aresta/ESP32-C3_Supercaps/img/boost_conv.jpg

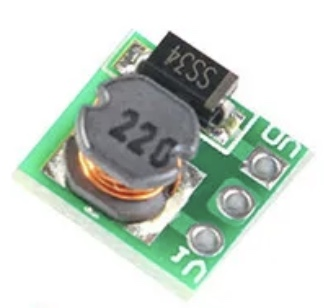
img/boost_conv.jpg
