aresta/ESP32-C3_Supercaps/img/ESP32-C3_Supermini3.jpg

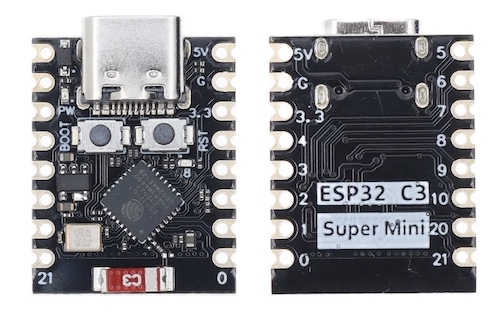
img/ESP32-C3_Supermini3.jpg
