aresta/ESP32-C3_Supercaps/img/ESP32-C3_Supermini.jpg

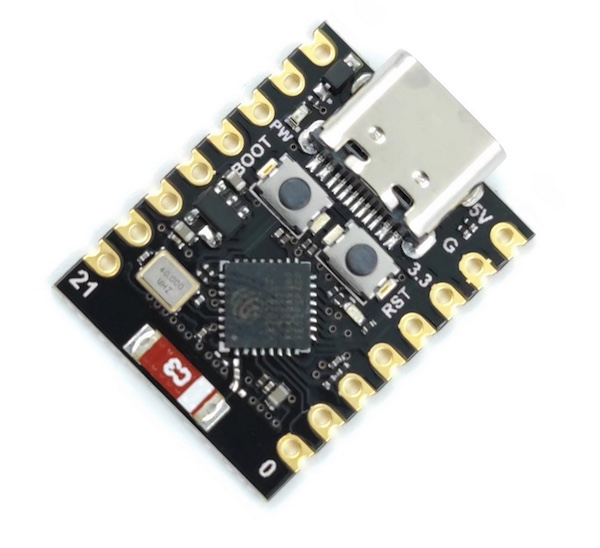
img/ESP32-C3_Supermini.jpg
