aresta/ESP32-C3_Supercaps/img/ESP32-C3_Supermini_pinout.jpeg

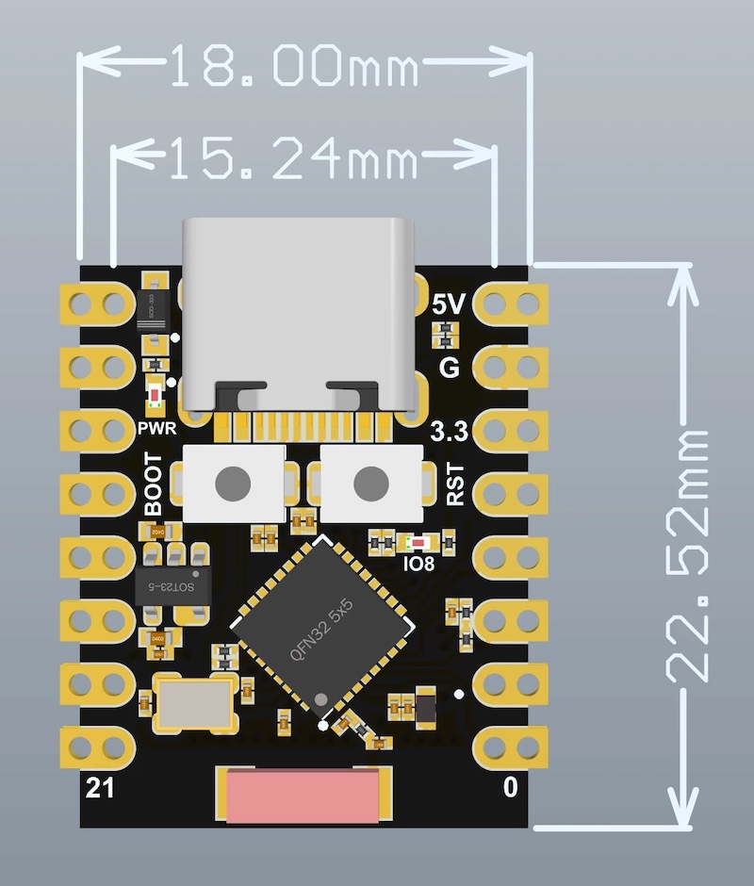
img/ESP32-C3_Supermini_pinout.jpeg
