aresta/ESP32-C3_Supercaps/img/ESP8685_sch.jpg

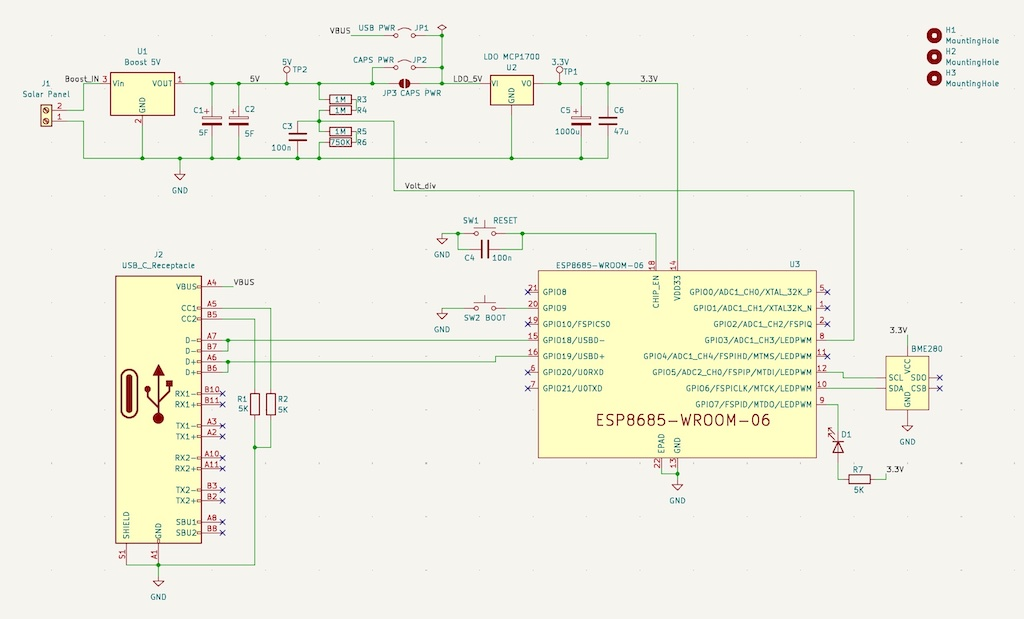
img/ESP8685_sch.jpg
