aresta/ESP32-C3_Supercaps/img/pcb.jpg

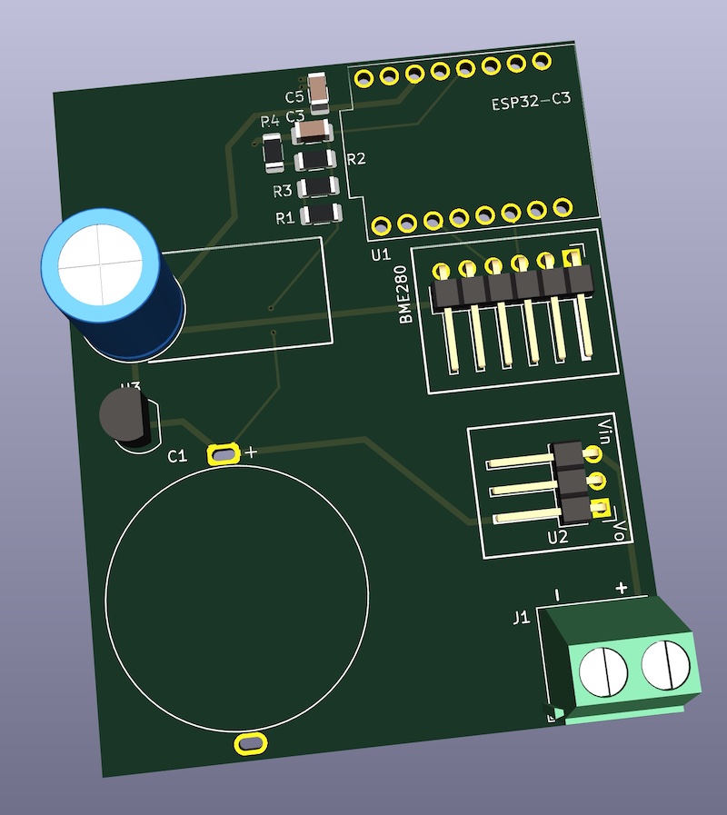
img/pcb.jpg
