aresta/ESP32-C3_Supercaps/img/solar_panel.jpg

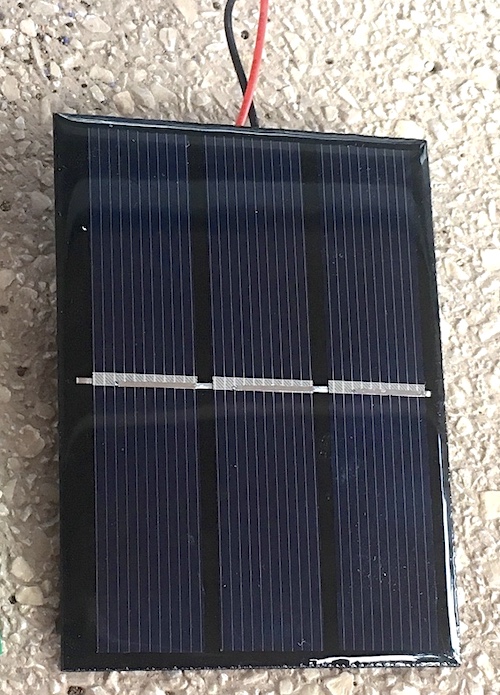
img/solar_panel.jpg
