aresta/ESP32-C3_Supercaps/img/Supercaps_5F.jpg

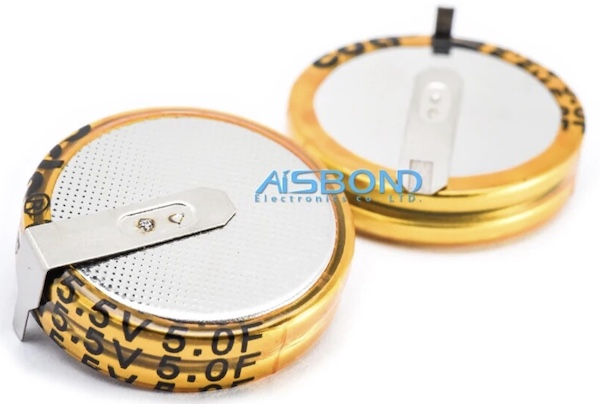
img/Supercaps_5F.jpg
