aresta/ESP32-C3_Supercaps/img/ESP8685-WeatherSt.kicad_pcb

## KiCad design img/ESP8685-WeatherSt.kicad_pcb (2026-07-29)

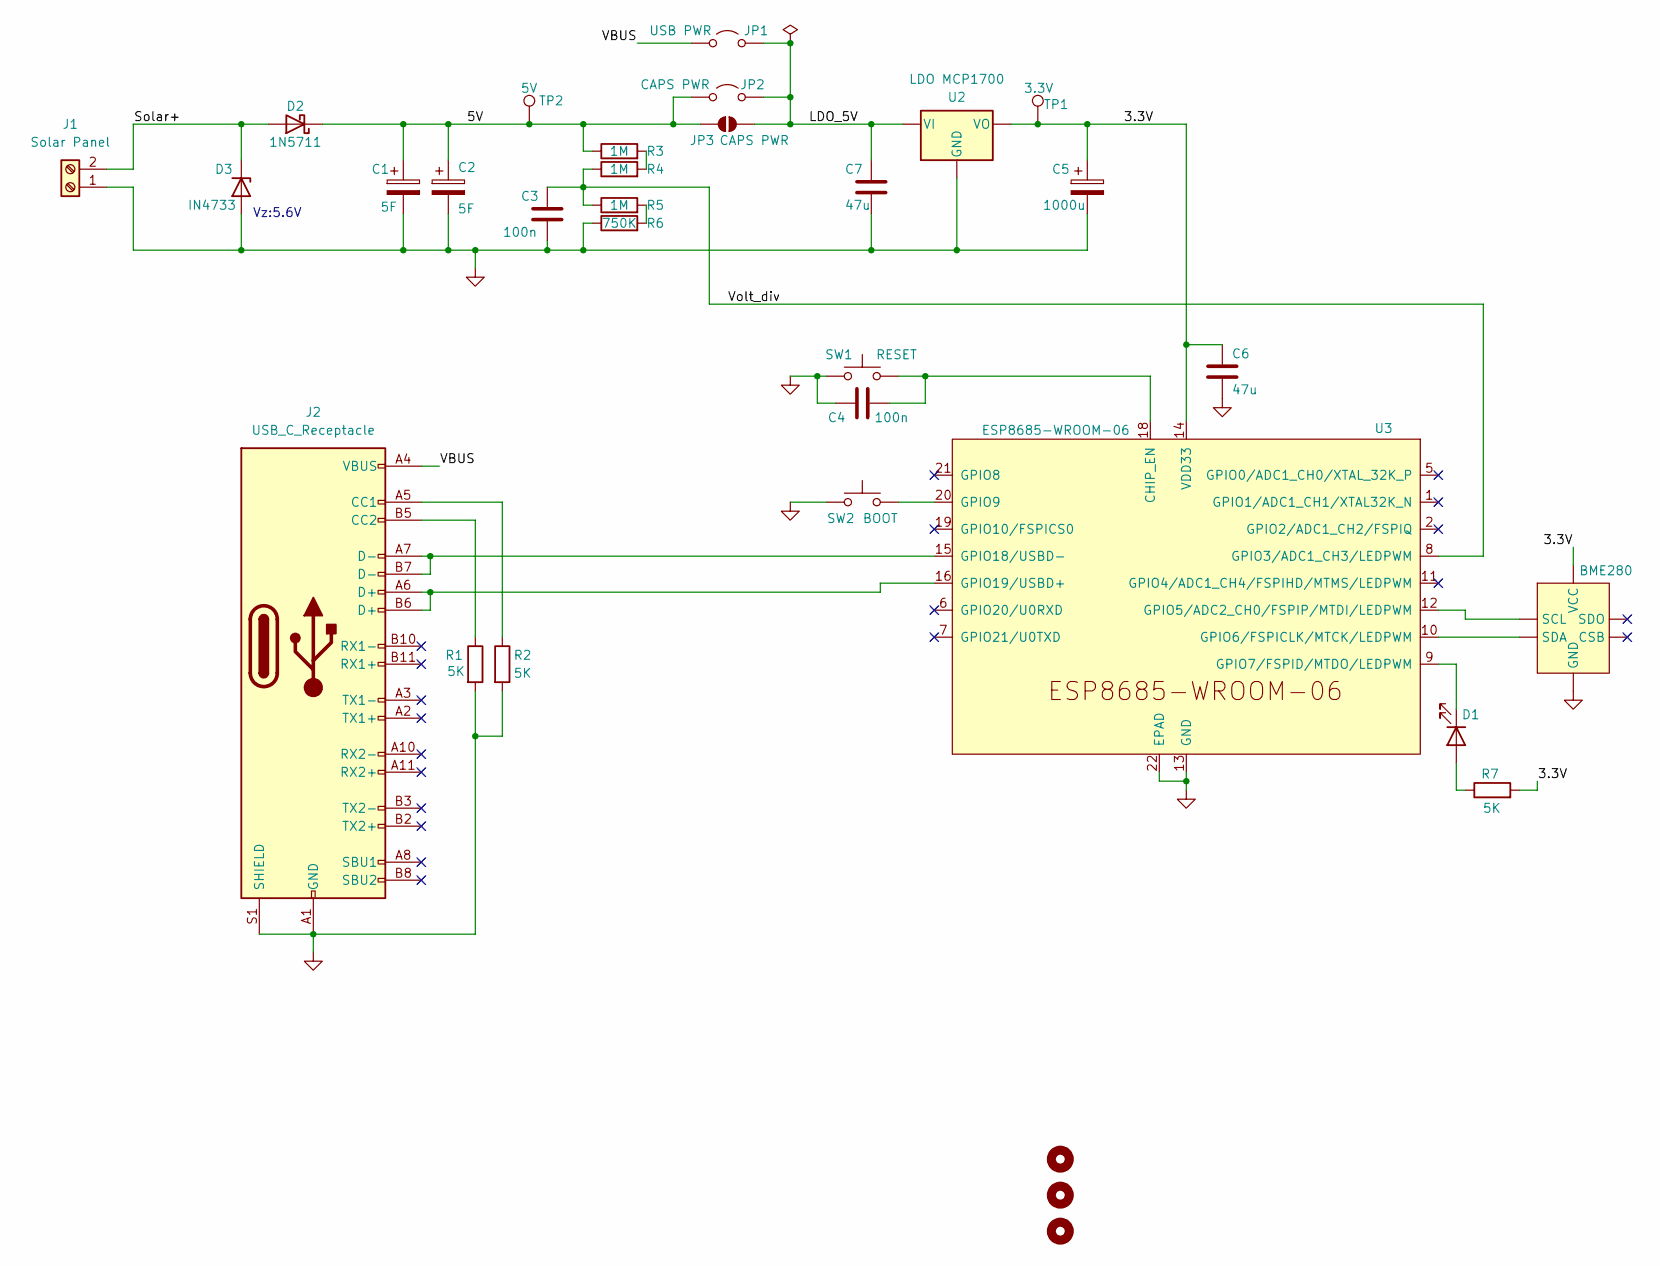
[picture p15: schematic ESP8685-WeatherSt.kicad_sch]

Parts:
BME1: BME280; PinHeader_1x06_P2.54mm_Horizontal
C1, C2: 5F; supercap
C3, C4: 100n; C_1206_3216Metric
C5: 1000u; C_Radial_D10.0mm_H16.0mm_P5.00mm
C6, C7: 47u; C_1206_3216Metric
D1: LED; LED_0805_2012Metric
D2: 1N5711; D_DO-35_SOD27_P7.62mm_Horizontal
D3: IN4733; D_DO-34_SOD68_P10.16mm_Horizontal
H1, H2, H3: MountingHole; MountingHole_2.2mm_M2_DIN965
J1: Solar Panel; TerminalBlock_Phoenix_MKDS-1,5-2-5.08_1x02_P5.08mm_Horizont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
J2: USB_C_Receptacle; USB_C_Receptacle_GCT_USB4105-xx-A_16P_TopMnt_Horizontal
JP1: USB PWR; PinHeader_1x02_P2.54mm_Vertical
JP2: CAPS PWR; PinHeader_1x02_P2.54mm_Vertical
JP3: CAPS PWR; SolderJumper-2_P1.3mm_Open_RoundedPad1.0x1.5mm
R1, R2, R7: 5K; R_1206_3216Metric
R3, R4, R5: 1M; R_1206_3216Metric
R6: 750K; R_1206_3216Metric
SW1: RESET; SW_Push_1P1T_NO_6x6mm_H9.5mm
SW2: BOOT; SW_Push_1P1T_NO_6x6mm_H9.5mm
TP1: 3.3V; TestPoint_Pad_D1.5mm
TP2: 5V; TestPoint_Pad_D1.5mm
U2: LDO MCP1700; TO-92_Inline
U3: ESP8685-WROOM-06

Connections:
/3.3V: BME1.1 (VCC), C5.1, C6.1, R7.2, TP1.1, U2.3 (VO), U3.14 (VDD33)
/5V: C1.1, C2.1, D2.1 (K), JP2.1 (A), JP3.1 (A), R3.1, TP2.1
/LDO_5V: C7.1, JP1.2 (B), JP2.2 (B), JP3.2 (B), U2.2 (VI)
/Solar+: D2.2 (A), D3.1 (K), J1.2
/VBUS: J2.A4 (VBUS), J2.A9 (VBUS), J2.B4 (VBUS), J2.B9 (VBUS), JP1.1 (A)
/Volt_div: C3.1, R4.1, R5.1, U3.8 (GPIO3/ADC1_CH3/LEDPWM)
GND: BME1.2 (GND), C1.2, C2.2, C3.2, C4.1, C5.2, C6.2, C7.2, D3.2 (A), J1.1, J2.A1 (GND), J2.A12 (GND), J2.B1 (GND), J2.B12 (GND), J2.S1 (SHIELD), R1.2, R2.2, R6.1, SW1.1, SW2.1, U2.1 (GND), U3.13 (GND), U3.22 (EPAD)
unnamed: BME1.3 (SCL), U3.12 (GPIO5/ADC2_CH0/FSPIP/MTDI/LEDPWM)
unnamed: BME1.4 (SDA), U3.10 (GPIO6/FSPICLK/MTCK/LEDPWM)
unnamed: D1.2 (A), R7.1
unnamed: D1.1 (K), U3.9 (GPIO7/FSPID/MTDO/LEDPWM)
unnamed: J2.A5 (CC1), R2.1
unnamed: J2.B5 (CC2), R1.1
unnamed: R3.2, R4.2
unnamed: R5.2, R6.2
unnamed: C4.2, SW1.2, U3.18 (CHIP_EN)
unnamed: SW2.2, U3.20 (GPIO9)
unnamed: J2.A7 (D-), J2.B7 (D-), U3.15 (GPIO18/USBD-)
unnamed: J2.A6 (D+), J2.B6 (D+), U3.16 (GPIO19/USBD+)

Notes on the sheet:
Vz:5.6V

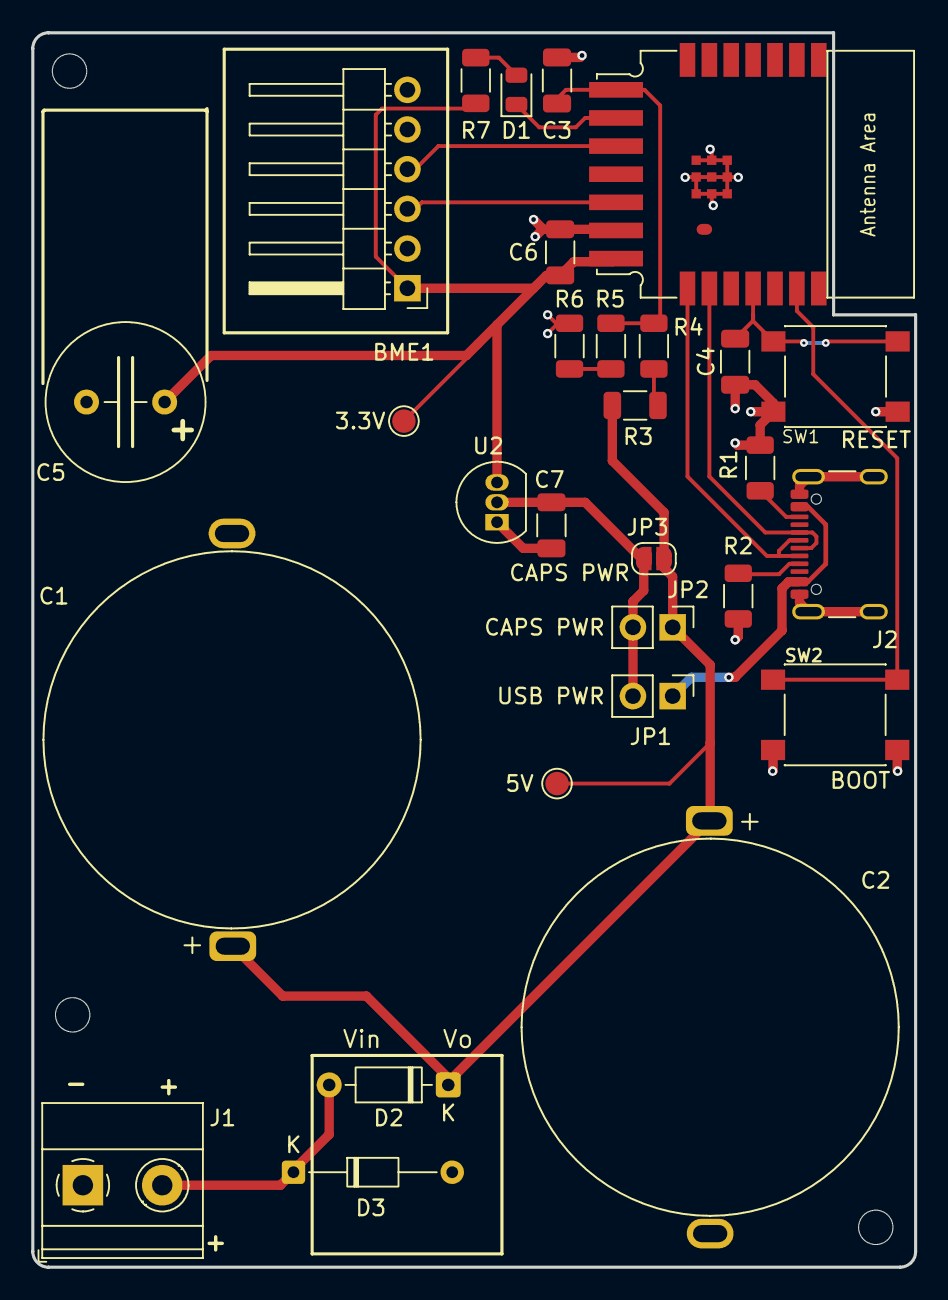
[picture p16: board ESP8685-WeatherSt.kicad_pcb from above]

Board: 2 copper layers, 56.5 x 79.0 mm, 32 parts (0 on the bottom side), 19 nets.
