aresta/ESP32-C3_Supercaps/(threads)

Thread 1 (2025-02-27):

Just hello

fel88, 2025-02-27:
Hello! I just want to thank you for your old project aresta/Supercaps :pray:  It inspired me (~2 years ago) to make my own project (https://github.com/fel88/TurtleBook)

aresta, 2025-03-01:
Very nice project!  Those hybrid capacitors is something that I want to check also, they look very interesting for different projects.
And I was thinking in doing something with epaper displays. Maybe a low power weather display panel, showing data from the weather station outside and from inside the house. It should last more than one year with a single AA rechargeable battery.
More ideas than time :-)
