aresta/ESP32-C3_Supercaps/(commit log)

2024-04-06 Moved to esp8685 and new PCB
2026-07-29 added redundacy sending samples twice with seq_id. Added Kicad files
